carrola1/CommandCenter/Lessons Learned.txt

- To get audio files playing I had to turn compile optimization ON (optimize for size).
  * Not sure why this is, but it may have something to do with an undefined array size
    in the fatfs code that is allocating more RAM than is allowable. Just a guess.
