carrola1/CommandCenter/Hardware/CommandCenter_BOM.xlsx

Id | Designator | Manufacturer | Part # | Description | Value | Package | Quantity | Cost/pc | Cost Total
1 | R33,R1,R2,R5,R7,R8,R9,R10,R11,R12,R14,R19,R23,R24,R26,R28,R30,R31,R32,R35,R37,R38,R39,R41,R42,R43,R44,R45,R46,R47,R34,R36 | Stackpole Electronics | RNCP0603FTD10K0 | 10k Resistor | 10k | 0603 | 32 | $0.03 | $0.87
2 | BAR4,BAR3 | Broadcom Limited | HDSP-4850 | Bar Graph (Green) | N/A | N/A | 2 | $5.83 | $11.66
3 | BAR1,BAR2 | Broadcom Limited | HDSP-4830 | Bar Graph (Red) | N/A | N/A | 2 | $6.06 | $12.12
4 | C6 |  |  |  | 0.1u | 0402 | 1 |  | $0.00
5 | C7,C12,C16,C17 | Samsung | CL10A106MQ8NNNC | 10uF Capacitor | 10u | 0603 | 4 | $0.11 | $0.44
6 | C8 | Samsung | CL10A105KP8NNNC | 1uF Capacitor | 1u | 0603 | 1 | $0.02 | $0.02
7 | C9,C11 | Samsung | CL10A225KO8NNNC | 2.2uF Capacitor | 2.2u | 0603 | 2 | $0.13 | $0.26
8 | C10 |  |  |  | 220u | 1206 | 1 |  | $0.00
9 | D1,D2 | Lite-On | LTST-C191KGKT | Green LED | LED | 0603 | 2 | $0.29 | $0.58
10 | J2 |  |  |  | Motor_Switches | PinHeader_1x04_P2.54mm_Vertical | 1 |  | $0.00
11 | J3,J17 | Amphenol | 20021121-00010C4LF | SWD Header | N/A | N/A | 2 | $0.84 | $1.68
12 | J4 |  |  |  | Motor | PinHeader_1x03_P2.54mm_Vertical | 1 |  | $0.00
13 | J5 | Molex | 5031821852 | Micro SD card holder | N/A | N/A | 1 | $2.45 | $2.45
14 | J6 |  |  |  | SPKR0 | PinHeader_1x02_P2.54mm_Vertical | 1 |  | $0.00
15 | J7 |  |  |  | SPKR1 | PinHeader_1x02_P2.54mm_Vertical | 1 |  | $0.00
16 | J8 |  |  |  | LED0 | PinHeader_1x02_P2.54mm_Vertical | 1 |  | $0.00
17 | J9 |  |  |  | LED1 | PinHeader_1x02_P2.54mm_Vertical | 1 |  | $0.00
18 | J10 |  |  |  | LED2 | PinHeader_1x02_P2.54mm_Vertical | 1 |  | $0.00
19 | J11 |  |  |  | LED3 | PinHeader_1x02_P2.54mm_Vertical | 1 |  | $0.00
20 | J12 |  |  |  | Wake | PinHeader_1x02_P2.54mm_Vertical | 1 |  | $0.00
21 | J15 |  |  |  | SW2 | PinHeader_1x02_P2.54mm_Vertical | 1 |  | $0.00
22 | J16 |  |  |  | SW3 | PinHeader_1x02_P2.54mm_Vertical | 1 |  | $0.00
23 | J18 |  |  |  | Bar Graph SW | PinHeader_1x09_P2.54mm_Vertical | 1 |  | $0.00
24 | L1 | Sumida | CDRH124NP-6R8MC | Inductor | 6.8uH | L_12x12mm_H4.5mm | 1 | $1.41 | $1.41
25 | Q1,Q2,Q3,Q4,Q5,Q6 | Diodes Inc | DMG1012T-7 | Dual N-Channel MOSFET | N/A | SOT-523 | 6 | $0.31 | $1.86
26 | R3,R20,R21,R25,R27,R29 | Stackpole Electronics | RMCF0603FT121R | 121 Resistor | 121 | 0603 | 6 | $0.01 | $0.04
27 | R4,R15,R17,R22 |  |  |  | DNP | 0603 | 4 |  | $0.00
28 | R6 | Stackpole Electronics | RMCF0603FT30K1 | 30k Resistor | 30k | 0603 | 1 | $0.02 | $0.02
29 | R13,R16,R18,R40 | Stackpole Electronics | RMCF0603FT100K | 100k Resistor | 100k | 0603 | 4 | $0.01 | $0.03
30 | R48 | TE Connectivity | CRGCQ0603F15K | 15k Resistor | 15k | 0603 | 1 | $0.03 | $0.03
31 | R49 | TE Connectivity | CRGCQ0603J22K | 22k Resistor | 22k | 0603 | 1 | $0.02 | $0.02
32 | U1 | Texas Instruments | TPS61032PWPR | 5V Boost Converter | TPS61032 | 16HTSSOP | 1 | $2.76 | $2.76
33 | U2,U6 | STMicroelectronics | STM32L052C8T6 | Microcontroller | N/A | 48LQFP | 2 | $3.77 | $7.54
34 | U3 | Microchip | MIC5225-3.3YM5-TR | 3.3V LDO | MIC5225 | SOT-23-5 | 1 | $0.40 | $0.40
35 | U4,U5 | Maxim | MAX98357AETE+T | I2S Class D Audio Amp | MAX98357 | 16TQFN | 2 | $2.40 | $4.80
36 | U7 | Broadcom Limited | APDS-9960 | Color sensor | APDS-9960 | Ambient_Prox_APDS-9960 | 1 | $2.72 | $2.72
37 | U8,U9,U10,U11,U12,U14,U15,U16,U17,U18,U19,U20,U21,U22,U23,U24,U25,U26,U27,U28 | SparkFun Electronics | COM-14863 | 10-pack APA102 RGB LED | N/A | N/A | 2 | $3.95 | $7.90
38 | U13 | Texas Instruments | SN74LVC2T45DCUR | Level translator | SN74LVC2T45 | US8 | 1 | $0.71 | $0.71
39 | U29 | Maxim | MAX7219CWG+T | Display driver | N/A | 24SOIC | 1 | $10.43 | $10.43
40 | U30 | Texas Instruments |  | Level translator | TXS0104EPWR | 14TSSOP | 1 |  | $0.00
41 | C1,C2,C3,C5,C13,C14,C15,C19,C20,C21,C22,C23,C24,C25,C26,C27,C28,C29,C30,C31,C32,C33,C34,C35,C36,C37,C38,C39,C40,C41,C42,C43,C44,C45,C46,C47,C48 | Samsung | CL10B104KB8NNNC | 0.1uF capacitor | 0.1u | 0603 | 37 | $0.01 | $0.46
42 | J1 | JST | S2B-PH-K-S(LF)(SN) | Battery connector | N/A | N/A | 1 | $0.17 | $0.17
43 | J13 |  |  |  | SW0 | PinHeader_1x02_P2.54mm_Vertical | 1 |  | $0.00
44 | J14 |  |  |  | SW1 | PinHeader_1x02_P2.54mm_Vertical | 1 |  | $0.00
 |  |  |  |  |  |  |  |  | $71.37
