carrola1/CommandCenter/Hardware/Part List.xlsx

Sheet: Sheet1
Part # | Description | Package | Vendor | Qty | Unit Cost | Total | In Stock
STM32L052C8T6 | Cortex-M0+, 64kB flash, 64kB RAM, 3xSPI/I2S. 1 DAC. | 48-LQFP | STMicro | 2 | $3.77 | $7.54
MAX98357A | I2S Class D audio amp | 16-TQFN | Maxim | 2 | $2.22 | $4.44
5031821852 | Micro SD connector | SMD | Molex | 1 | $2.33
TPS61032 | 5V boost converter | 16-TSSOP | TI | 1 | $2.76
MIC5225-3.3 | Linear regulator | SOT-23-5 | Microchip | 1 | $0.41
COM-14863 | DotStar | PLCC-6 | SparkFun | 2 | $3.95 |  | 4
LTST-C191KGKT | Green LED, 2V, 20mA | 0603 | Lite-On | 2 | $0.29
LTST-C191KFKT | Orange LED, 2V, 20mA | 0603 | Lite-On | 2 | $0.29
CDRH124NP-6R8MC | Inductor, 6.8uH | 12x12mm | Sumida | 1 | $1.41
SN74LVC2T45 | Dual Level Translator | 8-VSSOP | TI | 1 | $0.61
20021121-00010C4LF | 10-pin header - .005" | SMT | Amphenol | 2 | $0.84
APDS-9960 | Color/proximity sensor | SMD (8) | Broadcom | 1 | $2.72
1314 | Speaker - 3" Diameter - 4 Ohm 3 Watt | N/A | Adafruit | 2 | $1.95 |  | 2
HDSP-4830 | Red Bar Graph | DIP (8) | Broadcom | 2 | $6.06
HDSP-4850 | Green Bar Graph | DIP (8) | Broadcom | 2 | $5.83
1675 | SWD Programming cable |  | Adafruit | 1 | $2.95
DMG1012T-7 | N-Channel FET | SOT-523 | Diodes | 6 | $0.34
MAX7219 | LED driver | SOIC | Maxim | 1 | $10.43
TXB0104PW | Quad level translator | TSSOP | TI
2925 | Mini 8-way rotary selector switch |  | Adafruit | 1 | $1.95
1445 | 16mm Panel Mount Momentary Pushbutton - Red |  | Adafruit | 1 | $0.95 | $0.95 | 1
2046 | Potentiometer Knob - Soft Touch T18 - Red |  | Adafruit | 1 | $0.50 | $0.50
56DP30-01-1-AJN | Rotary switch - SP12T with adjustable stops |  | Digikey | 1 | $9.95 | $9.95 | 1
169 | Micro servo |  | Adafruit | 1 | $5.95 | $5.95 | 1
KO106A102 | Key lock switch (panel mount) |  | Digikey | 1 | $3.46 | $3.46 | 1
6081231110F | Green panel mount LED w/wires |  | Digikey | 1 | $3.25 | $3.25
6081131110F | Red panel mount LED w/wires |  | Digikey | 1 | $3.35 | $3.35
6083331110F | Yellow panel mount LED w/wires |  | Digikey | 1 | $3.25 | $3.25
‎S2B-PH-K-S | Power connector, right angle |  |  | 1 | $0.17 | $0.17
ST161D00 | SPST switch |  |  | 3
 | 3xAA battery holder
 | 0.1u | 0603 |  | 37
 | 10k | 0603 |  | 32
 | 0.1u | 0402 |  | 1
 | 10u | 0603 |  | 4
 | 1u | 0603 |  | 1
 | 2.2u | 0603 |  | 2
 | 220u | 1206 |  | 1
 | 121 | 0603 |  | 6
 | 30k | 0603 |  | 1
 | 100k | 0603 |  | 4
 | 15k | 0603 |  | 1
 | 22k | 0603 |  | 1
 | Test Point 2x2 mm |  |  | 9
 |  |  |  |  | TOTAL | $30.83

Sheet: Sheet3
Id | Designator | Package | Quantity | Designation | Supplier and ref | Column1 | _1
1 | R33,R1,R2,R5,R7,R8,R9,R10,R11,R12,R14,R19,R23,R24,R26,R28,R30,R31,R32,R35,R37,R38,R39,R41,R42,R43,R44,R45,R46,R47,R34,R36 | R_0603_1608Metric_Pad1.05x0.95mm_HandSolder | 32 | 10k
2 | BAR4,BAR1,BAR2,BAR3 | HDSP-4830 | 4 | HDSP-4830_2
3 | C6 | C_0402_1005Metric | 1 | 0.1u
4 | C7,C12,C16,C17 | C_0603_1608Metric_Pad1.05x0.95mm_HandSolder | 4 | 10u
5 | C8 | C_0603_1608Metric_Pad1.05x0.95mm_HandSolder | 1 | 1u
6 | C9,C11 | C_0603_1608Metric_Pad1.05x0.95mm_HandSolder | 2 | 2.2u
7 | C10 | C_1206_3216Metric_Pad1.42x1.75mm_HandSolder | 1 | 220u
8 | D1,D2 | LED_0603_1608Metric_Pad1.05x0.95mm_HandSolder | 2 | LED
9 | J2 | PinHeader_1x04_P2.54mm_Vertical | 1 | Motor_Switches
10 | J3,J17 | JLink_Mini_0p05 | 2 | JLink_Mini
11 | J4 | PinHeader_1x03_P2.54mm_Vertical | 1 | Motor
12 | J5 | MOLEX_503182-1852 | 1 | 503182-1852
13 | J6 | PinHeader_1x02_P2.54mm_Vertical | 1 | SPKR0
14 | J7 | PinHeader_1x02_P2.54mm_Vertical | 1 | SPKR1
15 | J8 | PinHeader_1x02_P2.54mm_Vertical | 1 | LED0
16 | J9 | PinHeader_1x02_P2.54mm_Vertical | 1 | LED1
17 | J10 | PinHeader_1x02_P2.54mm_Vertical | 1 | LED2
18 | J11 | PinHeader_1x02_P2.54mm_Vertical | 1 | LED3
19 | J12 | PinHeader_1x02_P2.54mm_Vertical | 1 | Wake
20 | J15 | PinHeader_1x02_P2.54mm_Vertical | 1 | SW2
21 | J16 | PinHeader_1x02_P2.54mm_Vertical | 1 | SW3
22 | J18 | PinHeader_1x09_P2.54mm_Vertical | 1 | Bar Graph SW
23 | L1 | L_12x12mm_H4.5mm | 1 | 6.8u
24 | Q1,Q2,Q3,Q4,Q5,Q6 | SOT-523 | 6 | DMG1012T-7
25 | R3,R20,R21,R25,R27,R29 | R_0603_1608Metric_Pad1.05x0.95mm_HandSolder | 6 | 121
26 | R4,R15,R17,R22 | R_0603_1608Metric_Pad1.05x0.95mm_HandSolder | 4 | DNP
27 | R6 | R_0603_1608Metric_Pad1.05x0.95mm_HandSolder | 1 | 30k
28 | R13,R16,R18,R40 | R_0603_1608Metric_Pad1.05x0.95mm_HandSolder | 4 | 100k
29 | R48 | R_0603_1608Metric_Pad1.05x0.95mm_HandSolder | 1 | 15k
30 | R49 | R_0603_1608Metric_Pad1.05x0.95mm_HandSolder | 1 | 22k
31 | TP1 | TestPoint_Pad_2.0x2.0mm | 1 | MOSI
32 | TP2 | TestPoint_Pad_2.0x2.0mm | 1 | MISO
33 | TP3 | TestPoint_Pad_2.0x2.0mm | 1 | SCK
34 | TP4 | TestPoint_Pad_2.0x2.0mm | 1 | NSS
35 | TP5 | TestPoint_Pad_2.0x2.0mm | 1 | I2S_WS
36 | TP6 | TestPoint_Pad_2.0x2.0mm | 1 | I2S_CK
37 | TP7 | TestPoint_Pad_2.0x2.0mm | 1 | I2S_SD
38 | TP8 | TestPoint_Pad_2.0x2.0mm | 1 | DOTSTAR_DATA
39 | TP9 | TestPoint_Pad_2.0x2.0mm | 1 | DOTSTAR_CLK
40 | U1 | SOP65P640X120-17N | 1 | TPS61032
41 | U2,U6 | QFP50P900X900X160-48N | 2 | STM32L0-LQFP48
42 | U3 | SOT-23-5 | 1 | MIC5225
43 | U4,U5 | QFN50P300X300X80-17N | 2 | MAX98357
44 | U7 | Ambient_Prox_APDS-9960 | 1 | APDS-9960
45 | U8,U9,U10,U11,U12,U14,U15,U16,U17,U18,U19,U20,U21,U22,U23,U24,U25,U26,U27,U28 | APA102_hand_solder | 20 | APA102
46 | U13 | SOP50P310X90-8N | 1 | SN74LVC2T45
47 | U29 | SOIC-24W_7.5x15.4mm_P1.27mm | 1 | MAX7219
48 | U30 | TSSOP-14_4.4x5mm_P0.65mm | 1 | TXB0104PW
49 | C1,C2,C3,C5,C13,C14,C15,C19,C20,C21,C22,C23,C24,C25,C26,C27,C28,C29,C30,C31,C32,C33,C34,C35,C36,C37,C38,C39,C40,C41,C42,C43,C44,C45,C46,C47,C48 | C_0603_1608Metric_Pad1.05x0.95mm_HandSolder | 37 | 0.1u
50 | MK1,MK2,MK3,MKe | MountingHole_3.2mm_M3 | 4 | Mounting_Hole
51 | J1 | JST_PH_S2B-PH-K_1x02_P2.00mm_Horizontal | 1 | Battery
52 | J13 | PinHeader_1x02_P2.54mm_Vertical | 1 | SW0
53 | J14 | PinHeader_1x02_P2.54mm_Vertical | 1 | SW1
