carrola1/CommandCenter/Hardware/CommandCenter_KICAD/CommandCenter_KICAD.kicad_pcb

## KiCad design Hardware/CommandCenter_KICAD/CommandCenter_KICAD.kicad_pcb (2019-08-28)

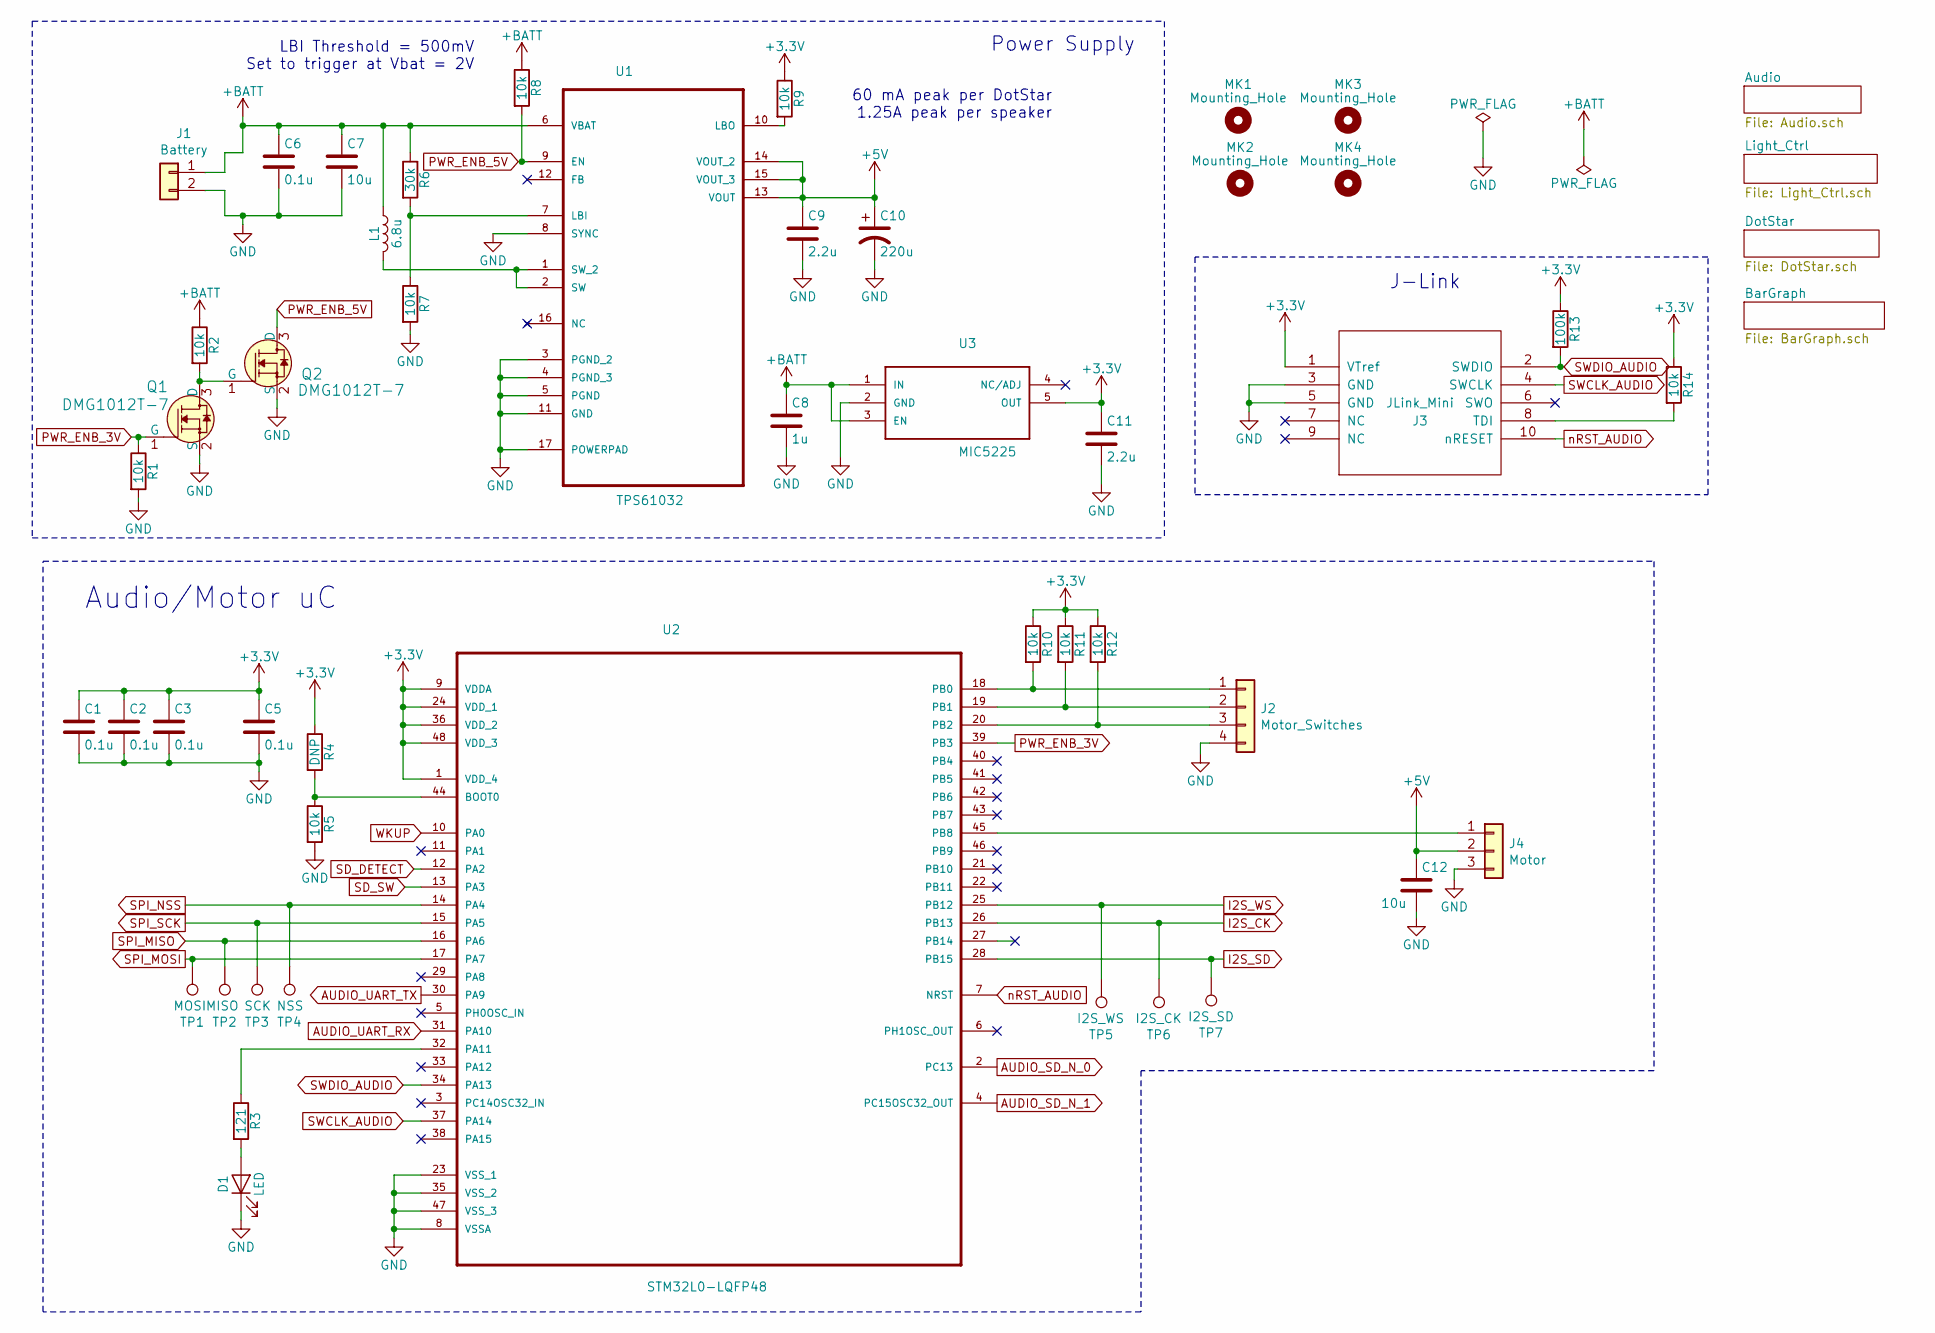
[picture p1: schematic CommandCenter_KICAD.sch]

Parts:
C1, C2, C3, C5: 0.1u; C_0603_1608Metric_Pad1.05x0.95mm_HandSolder
C6: 0.1u; C_0402_1005Metric
C7, C12: 10u; C_0603_1608Metric_Pad1.05x0.95mm_HandSolder
C8: 1u; C_0603_1608Metric_Pad1.05x0.95mm_HandSolder
C9, C11: 2.2u; C_0603_1608Metric_Pad1.05x0.95mm_HandSolder
C10: 220u; C_1206_3216Metric_Pad1.42x1.75mm_HandSolder
D1: LED; LED_0603_1608Metric_Pad1.05x0.95mm_HandSolder
J1: Battery; JST_PH_S2B-PH-K_1x02_P2.00mm_Horizontal
J2: Motor_Switches; PinHeader_1x04_P2.54mm_Vertical
J3: JLink_Mini; JLink_Mini_0p05
J4: Motor; PinHeader_1x03_P2.54mm_Vertical
L1: 6.8u; L_12x12mm_H4.5mm
MK1, MK2, MK3, MK4: Mounting_Hole; MountingHole_3.2mm_M3
Q1, Q2: DMG1012T-7; SOT-523; MPN DMG1012T-7; Digi-Key_PN DMG1012T-7DICT-ND
R1, R2, R5, R7, R8, R9, R10, R11, R12, R14: 10k; R_0603_1608Metric_Pad1.05x0.95mm_HandSolder
R3: 121; R_0603_1608Metric_Pad1.05x0.95mm_HandSolder
R4: DNP; R_0603_1608Metric_Pad1.05x0.95mm_HandSolder
R6: 30k; R_0603_1608Metric_Pad1.05x0.95mm_HandSolder
R13: 100k; R_0603_1608Metric_Pad1.05x0.95mm_HandSolder
TP1: MOSI; TestPoint_Pad_2.0x2.0mm
TP2: MISO; TestPoint_Pad_2.0x2.0mm
TP3: SCK; TestPoint_Pad_2.0x2.0mm
TP4: NSS; TestPoint_Pad_2.0x2.0mm
TP5: I2S_WS; TestPoint_Pad_2.0x2.0mm
TP6: I2S_CK; TestPoint_Pad_2.0x2.0mm
TP7: I2S_SD; TestPoint_Pad_2.0x2.0mm
U1: TPS61032; SOP65P640X120-17N
U2: STM32L0-LQFP48; QFP50P900X900X160-48N
U3: MIC5225; SOT-23-5

Connections:
+3V3: C1.1, C2.1, C3.1, C5.1, C11.1, J3.1 (VTref), R4.1, R9.1, R10.1, R11.1, R12.1, R13.1, R14.1, U2.1 (VDD_4), U2.9 (VDDA), U2.24 (VDD_1), U2.36 (VDD_2), U2.48 (VDD_3), U3.5 (OUT); also elsewhere on the board
+5V: C9.1, C10.1, C12.1, J4.2, U1.13 (VOUT), U1.14 (VOUT_2), U1.15 (VOUT_3); also elsewhere on the board
+BATT: C6.1, C7.1, C8.1, J1.1, L1.1, R2.1, R6.1, R8.1, U1.6 (VBAT), U3.1 (IN), U3.3 (EN)
AUDIO_SD_N_0: U2.2 (PC13); also elsewhere on the board
AUDIO_SD_N_1: U2.4 (PC15OSC32_OUT); also elsewhere on the board
AUDIO_UART_RX: U2.31 (PA10); also elsewhere on the board
AUDIO_UART_TX: U2.30 (PA9); also elsewhere on the board
GND: C1.2, C2.2, C3.2, C5.2, C6.2, C7.2, C8.2, C9.2, C10.2, C11.2, C12.2, D1.1 (K), J1.2, J2.4, J3.3 (GND), J3.5 (GND), J4.3, Q1.2 (S), Q2.2 (S), R1.2, R5.2, R7.2, U1.3 (PGND_2), U1.4 (PGND_3), U1.5 (PGND), U1.8 (SYNC), U1.11 (GND), U1.17 (POWERPAD), U2.8 (VSSA), U2.23 (VSS_1), U2.35 (VSS_2), U2.47 (VSS_3), U3.2 (GND); also elsewhere on the board
I2S_CK: TP6.1, U2.26 (PB13); also elsewhere on the board
I2S_SD: TP7.1, U2.28 (PB15); also elsewhere on the board
I2S_WS: TP5.1, U2.25 (PB12); also elsewhere on the board
unnamed: D1.2 (A), R3.2
unnamed: J2.1, R10.2, U2.18 (PB0)
unnamed: J2.2, R11.2, U2.19 (PB1)
unnamed: J2.3, R12.2, U2.20 (PB2)
unnamed: J3.8 (TDI), R14.2
unnamed: J4.1, U2.45 (PB8)
unnamed: L1.2, U1.1 (SW_2), U1.2 (SW)
unnamed: Q1.3 (D), Q2.1 (G), R2.2
unnamed: R3.1, U2.32 (PA11)
unnamed: R4.2, R5.1, U2.44 (BOOT0)
unnamed: R6.2, R7.1, U1.7 (LBI)
unnamed: R9.2, U1.10 (LBO)
PWR_ENB_3V: Q1.1 (G), R1.1, U2.39 (PB3)
PWR_ENB_5V: Q2.3 (D), R8.2, U1.9 (EN)
SD_DETECT: U2.12 (PA2); also elsewhere on the board
SD_SW: U2.13 (PA3); also elsewhere on the board
SPI_MISO: TP2.1, U2.16 (PA6); also elsewhere on the board
SPI_MOSI: TP1.1, U2.17 (PA7); also elsewhere on the board
SPI_NSS: TP4.1, U2.14 (PA4); also elsewhere on the board
SPI_SCK: TP3.1, U2.15 (PA5); also elsewhere on the board
SWCLK_AUDIO: J3.4 (SWCLK), U2.37 (PA14)
SWDIO_AUDIO: J3.2 (SWDIO), R13.2, U2.34 (PA13)
WKUP: U2.10 (PA0); also elsewhere on the board
nRST_AUDIO: J3.10 (nRESET), U2.7 (NRST)

Notes on the sheet:
Power Supply
J-Link
Audio/Motor uC
60 mA peak per DotStar 1.25A peak per speaker
LBI Threshold = 500mV Set to trigger at Vbat = 2V

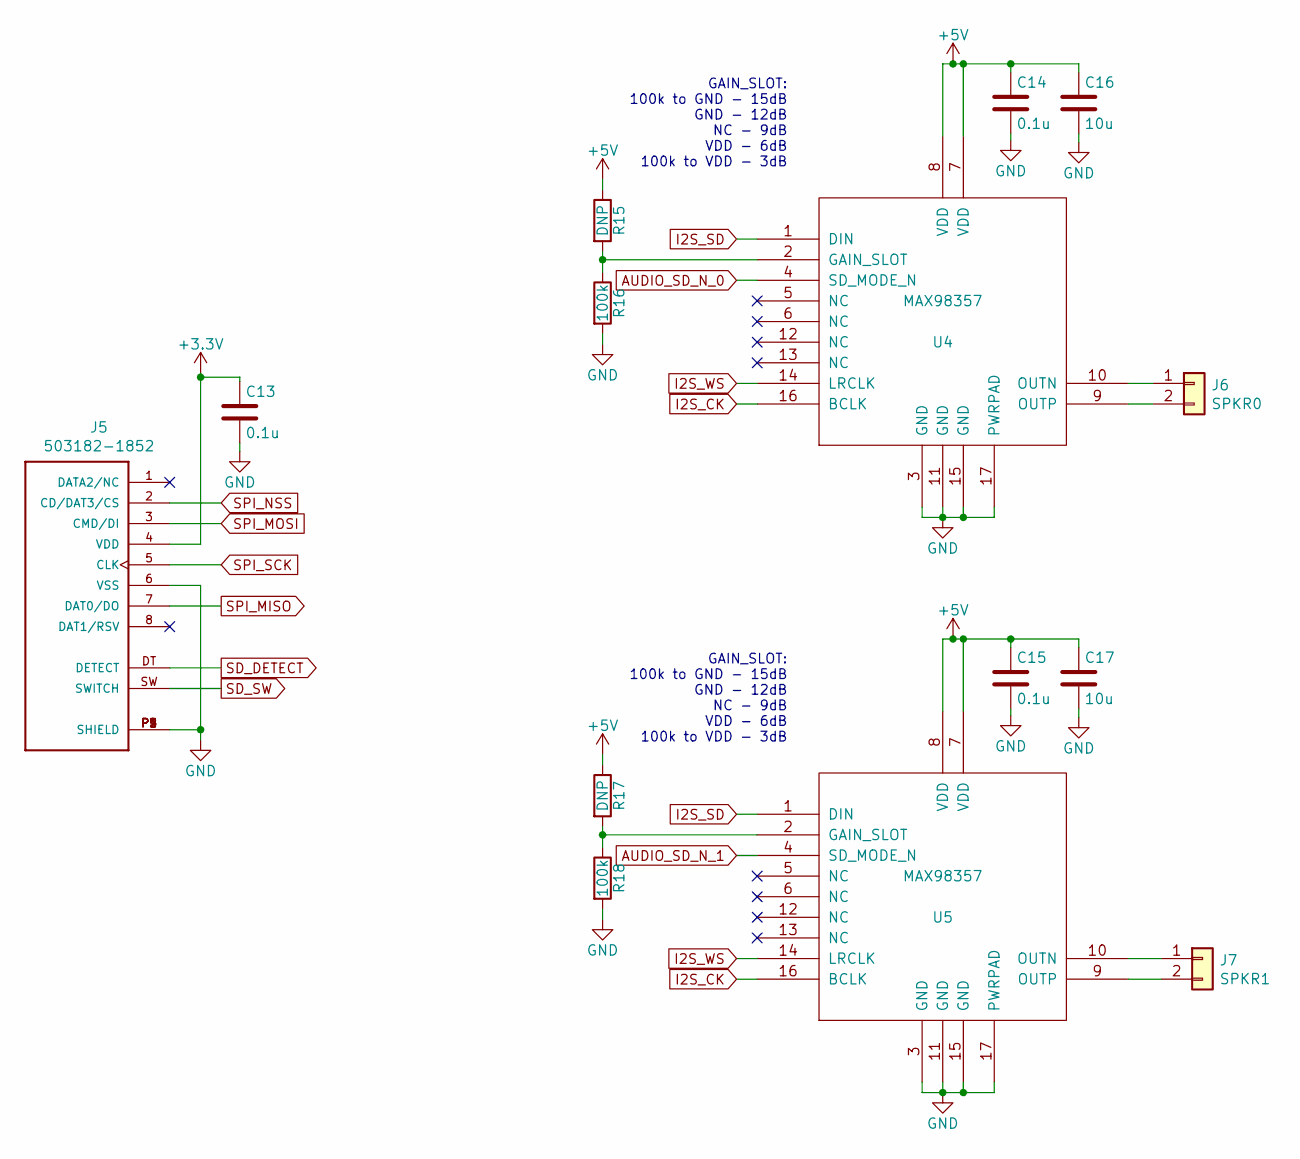
[picture p2: schematic Audio.sch]

Parts:
C13, C14, C15: 0.1u; C_0603_1608Metric_Pad1.05x0.95mm_HandSolder
C16, C17: 10u; C_0603_1608Metric_Pad1.05x0.95mm_HandSolder
J5: 503182-1852; MOLEX_503182-1852
J6: SPKR0; PinHeader_1x02_P2.54mm_Vertical
J7: SPKR1; PinHeader_1x02_P2.54mm_Vertical
R15, R17: DNP; R_0603_1608Metric_Pad1.05x0.95mm_HandSolder
R16, R18: 100k; R_0603_1608Metric_Pad1.05x0.95mm_HandSolder
U4, U5: MAX98357; QFN50P300X300X80-17N

Connections:
+3V3: C13.1, J5.4 (VDD); also elsewhere on the board
+5V: C14.1, C15.1, C16.1, C17.1, R15.1, R17.1, U4.7 (VDD), U4.8 (VDD), U5.7 (VDD), U5.8 (VDD); also elsewhere on the board
AUDIO_SD_N_0: U4.4 (SD_MODE_N); also elsewhere on the board
AUDIO_SD_N_1: U5.4 (SD_MODE_N); also elsewhere on the board
GND: C13.2, C14.2, C15.2, C16.2, C17.2, J5.6 (VSS), J5.P1 (SHIELD), J5.P2 (SHIELD), J5.P3 (SHIELD), J5.P4 (SHIELD), J5.P5 (SHIELD), R16.2, R18.2, U4.3 (GND), U4.11 (GND), U4.15 (GND), U4.17 (PWRPAD), U5.3 (GND), U5.11 (GND), U5.15 (GND), U5.17 (PWRPAD); also elsewhere on the board
I2S_CK: U4.16 (BCLK), U5.16 (BCLK); also elsewhere on the board
I2S_SD: U4.1 (DIN), U5.1 (DIN); also elsewhere on the board
I2S_WS: U4.14 (LRCLK), U5.14 (LRCLK); also elsewhere on the board
unnamed: J6.1, U4.10 (OUTN)
unnamed: J6.2, U4.9 (OUTP)
unnamed: J7.1, U5.10 (OUTN)
unnamed: J7.2, U5.9 (OUTP)
unnamed: R15.2, R16.1, U4.2 (GAIN_SLOT)
unnamed: R17.2, R18.1, U5.2 (GAIN_SLOT)
SD_DETECT: J5.DT (DETECT); also elsewhere on the board
SD_SW: J5.SW (SWITCH); also elsewhere on the board
SPI_MISO: J5.7 (DAT0/DO); also elsewhere on the board
SPI_MOSI: J5.3 (CMD/DI); also elsewhere on the board
SPI_NSS: J5.2 (CD/DAT3/CS); also elsewhere on the board
SPI_SCK: J5.5 (CLK); also elsewhere on the board

Notes on the sheet:
GAIN_SLOT: 100k to GND - 15dB GND - 12dB NC - 9dB VDD - 6dB 100k to VDD - 3dB

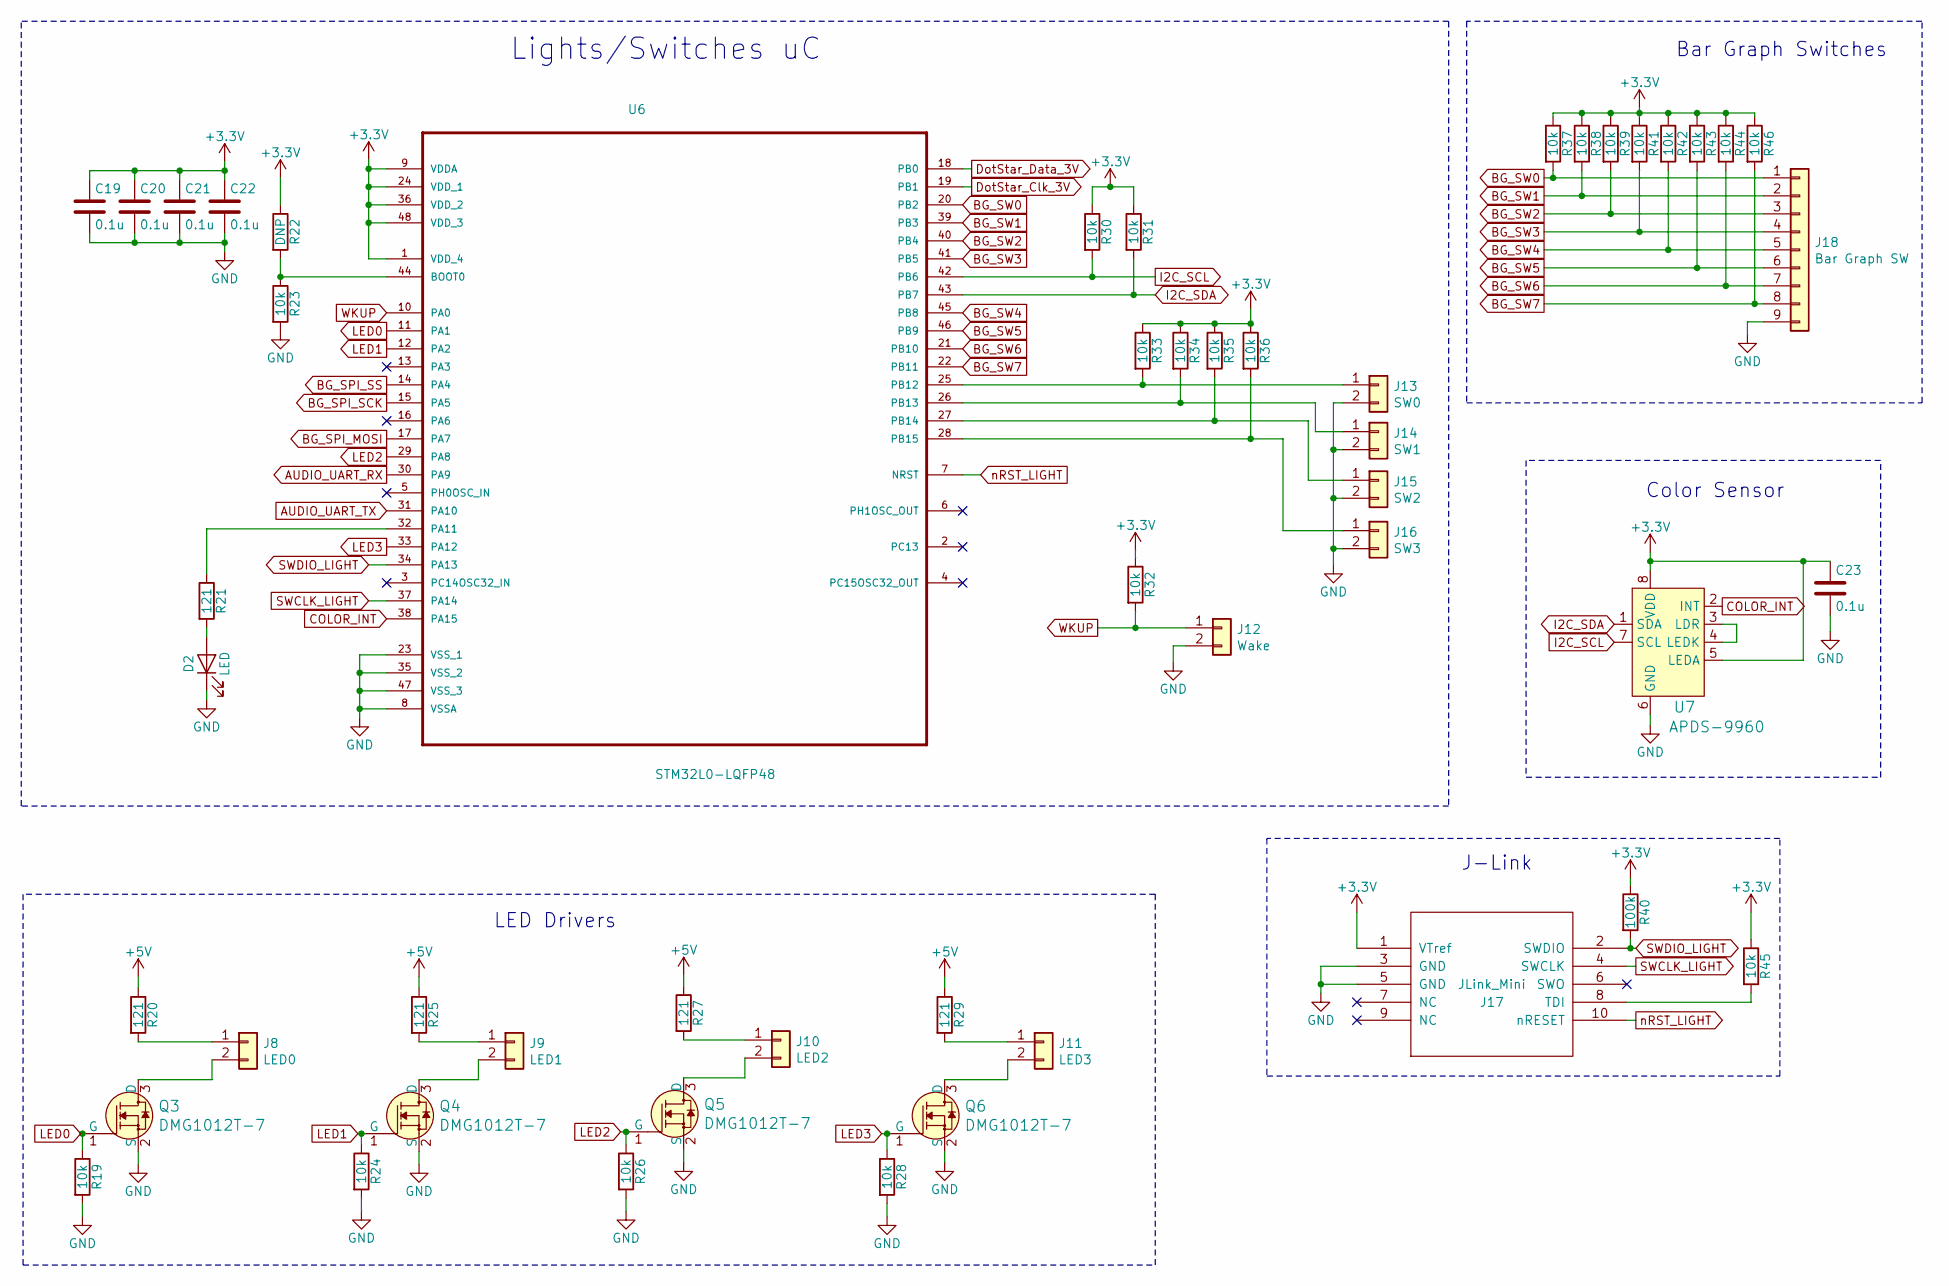
[picture p3: schematic Light_Ctrl.sch]

Parts:
C19, C20, C21, C22, C23: 0.1u; C_0603_1608Metric_Pad1.05x0.95mm_HandSolder
D2: LED; LED_0603_1608Metric_Pad1.05x0.95mm_HandSolder
J8: LED0; PinHeader_1x02_P2.54mm_Vertical
J9: LED1; PinHeader_1x02_P2.54mm_Vertical
J10: LED2; PinHeader_1x02_P2.54mm_Vertical
J11: LED3; PinHeader_1x02_P2.54mm_Vertical
J12: Wake; PinHeader_1x02_P2.54mm_Vertical
J13: SW0; PinHeader_1x02_P2.54mm_Vertical
J14: SW1; PinHeader_1x02_P2.54mm_Vertical
J15: SW2; PinHeader_1x02_P2.54mm_Vertical
J16: SW3; PinHeader_1x02_P2.54mm_Vertical
J17: JLink_Mini; JLink_Mini_0p05
J18: Bar Graph SW; PinHeader_1x09_P2.54mm_Vertical
Q3, Q4, Q5, Q6: DMG1012T-7; SOT-523; MPN DMG1012T-7; Digi-Key_PN DMG1012T-7DICT-ND
R19, R23, R24, R26, R28, R30, R31, R32, R33, R34, R35, R36, R37, R38, R39, R41, R42, R43, R44, R45, R46: 10k; R_0603_1608Metric_Pad1.05x0.95mm_HandSolder
R20, R21, R25, R27, R29: 121; R_0603_1608Metric_Pad1.05x0.95mm_HandSolder
R22: DNP; R_0603_1608Metric_Pad1.05x0.95mm_HandSolder
R40: 100k; R_0603_1608Metric_Pad1.05x0.95mm_HandSolder
U6: STM32L0-LQFP48; QFP50P900X900X160-48N
U7: APDS-9960; Ambient_Prox_APDS-9960; MPN APDS-9960; Digi-Key_PN 516-3480-1-ND

Connections:
+3V3: C19.1, C20.1, C21.1, C22.1, C23.1, J17.1 (VTref), R22.1, R30.1, R31.1, R32.1, R33.1, R34.1, R35.1, R36.1, R37.1, R38.1, R39.1, R40.1, R41.1, R42.1, R43.1, R44.1, R45.1, R46.1, U6.1 (VDD_4), U6.9 (VDDA), U6.24 (VDD_1), U6.36 (VDD_2), U6.48 (VDD_3), U7.5 (LEDA), U7.8 (VDD); also elsewhere on the board
+5V: R20.1, R25.1, R27.1, R29.1; also elsewhere on the board
AUDIO_UART_RX: U6.30 (PA9); also elsewhere on the board
AUDIO_UART_TX: U6.31 (PA10); also elsewhere on the board
BG_SPI_MOSI: U6.17 (PA7); also elsewhere on the board
BG_SPI_SCK: U6.15 (PA5); also elsewhere on the board
BG_SPI_SS: U6.14 (PA4); also elsewhere on the board
BG_SW0: J18.1, R37.2, U6.20 (PB2)
BG_SW1: J18.2, R38.2, U6.39 (PB3)
BG_SW2: J18.3, R39.2, U6.40 (PB4)
BG_SW3: J18.4, R41.2, U6.41 (PB5)
BG_SW4: J18.5, R42.2, U6.45 (PB8)
BG_SW5: J18.6, R43.2, U6.46 (PB9)
BG_SW6: J18.7, R44.2, U6.21 (PB10)
BG_SW7: J18.8, R46.2, U6.22 (PB11)
COLOR_INT: U6.38 (PA15), U7.2 (INT)
DotStar_Clk_3V: U6.19 (PB1); also elsewhere on the board
DotStar_Data_3V: U6.18 (PB0); also elsewhere on the board
GND: C19.2, C20.2, C21.2, C22.2, C23.2, D2.1 (K), J12.2, J13.2, J14.2, J15.2, J16.2, J17.3 (GND), J17.5 (GND), J18.9, Q3.2 (S), Q4.2 (S), Q5.2 (S), Q6.2 (S), R19.2, R23.2, R24.2, R26.2, R28.2, U6.8 (VSSA), U6.23 (VSS_1), U6.35 (VSS_2), U6.47 (VSS_3), U7.6 (GND); also elsewhere on the board
I2C_SCL: R30.2, U6.42 (PB6), U7.7 (SCL)
I2C_SDA: R31.2, U6.43 (PB7), U7.1 (SDA)
LED0: Q3.1 (G), R19.1, U6.11 (PA1)
LED1: Q4.1 (G), R24.1, U6.12 (PA2)
LED2: Q5.1 (G), R26.1, U6.29 (PA8)
LED3: Q6.1 (G), R28.1, U6.33 (PA12)
unnamed: D2.2 (A), R21.2
unnamed: J8.1, R20.2
unnamed: J8.2, Q3.3 (D)
unnamed: J9.1, R25.2
unnamed: J9.2, Q4.3 (D)
unnamed: J10.1, R27.2
unnamed: J10.2, Q5.3 (D)
unnamed: J11.1, R29.2
unnamed: J11.2, Q6.3 (D)
unnamed: J13.1, R33.2, U6.25 (PB12)
unnamed: J14.1, R34.2, U6.26 (PB13)
unnamed: J15.1, R35.2, U6.27 (PB14)
unnamed: J16.1, R36.2, U6.28 (PB15)
unnamed: J17.8 (TDI), R45.2
unnamed: R21.1, U6.32 (PA11)
unnamed: R22.2, R23.1, U6.44 (BOOT0)
unnamed: U7.3 (LDR), U7.4 (LEDK)
SWCLK_LIGHT: J17.4 (SWCLK), U6.37 (PA14)
SWDIO_LIGHT: J17.2 (SWDIO), R40.2, U6.34 (PA13)
WKUP: J12.1, R32.2, U6.10 (PA0); also elsewhere on the board
nRST_LIGHT: J17.10 (nRESET), U6.7 (NRST)

Notes on the sheet:
Lights/Switches uC
J-Link
LED Drivers
Color Sensor
Bar Graph Switches

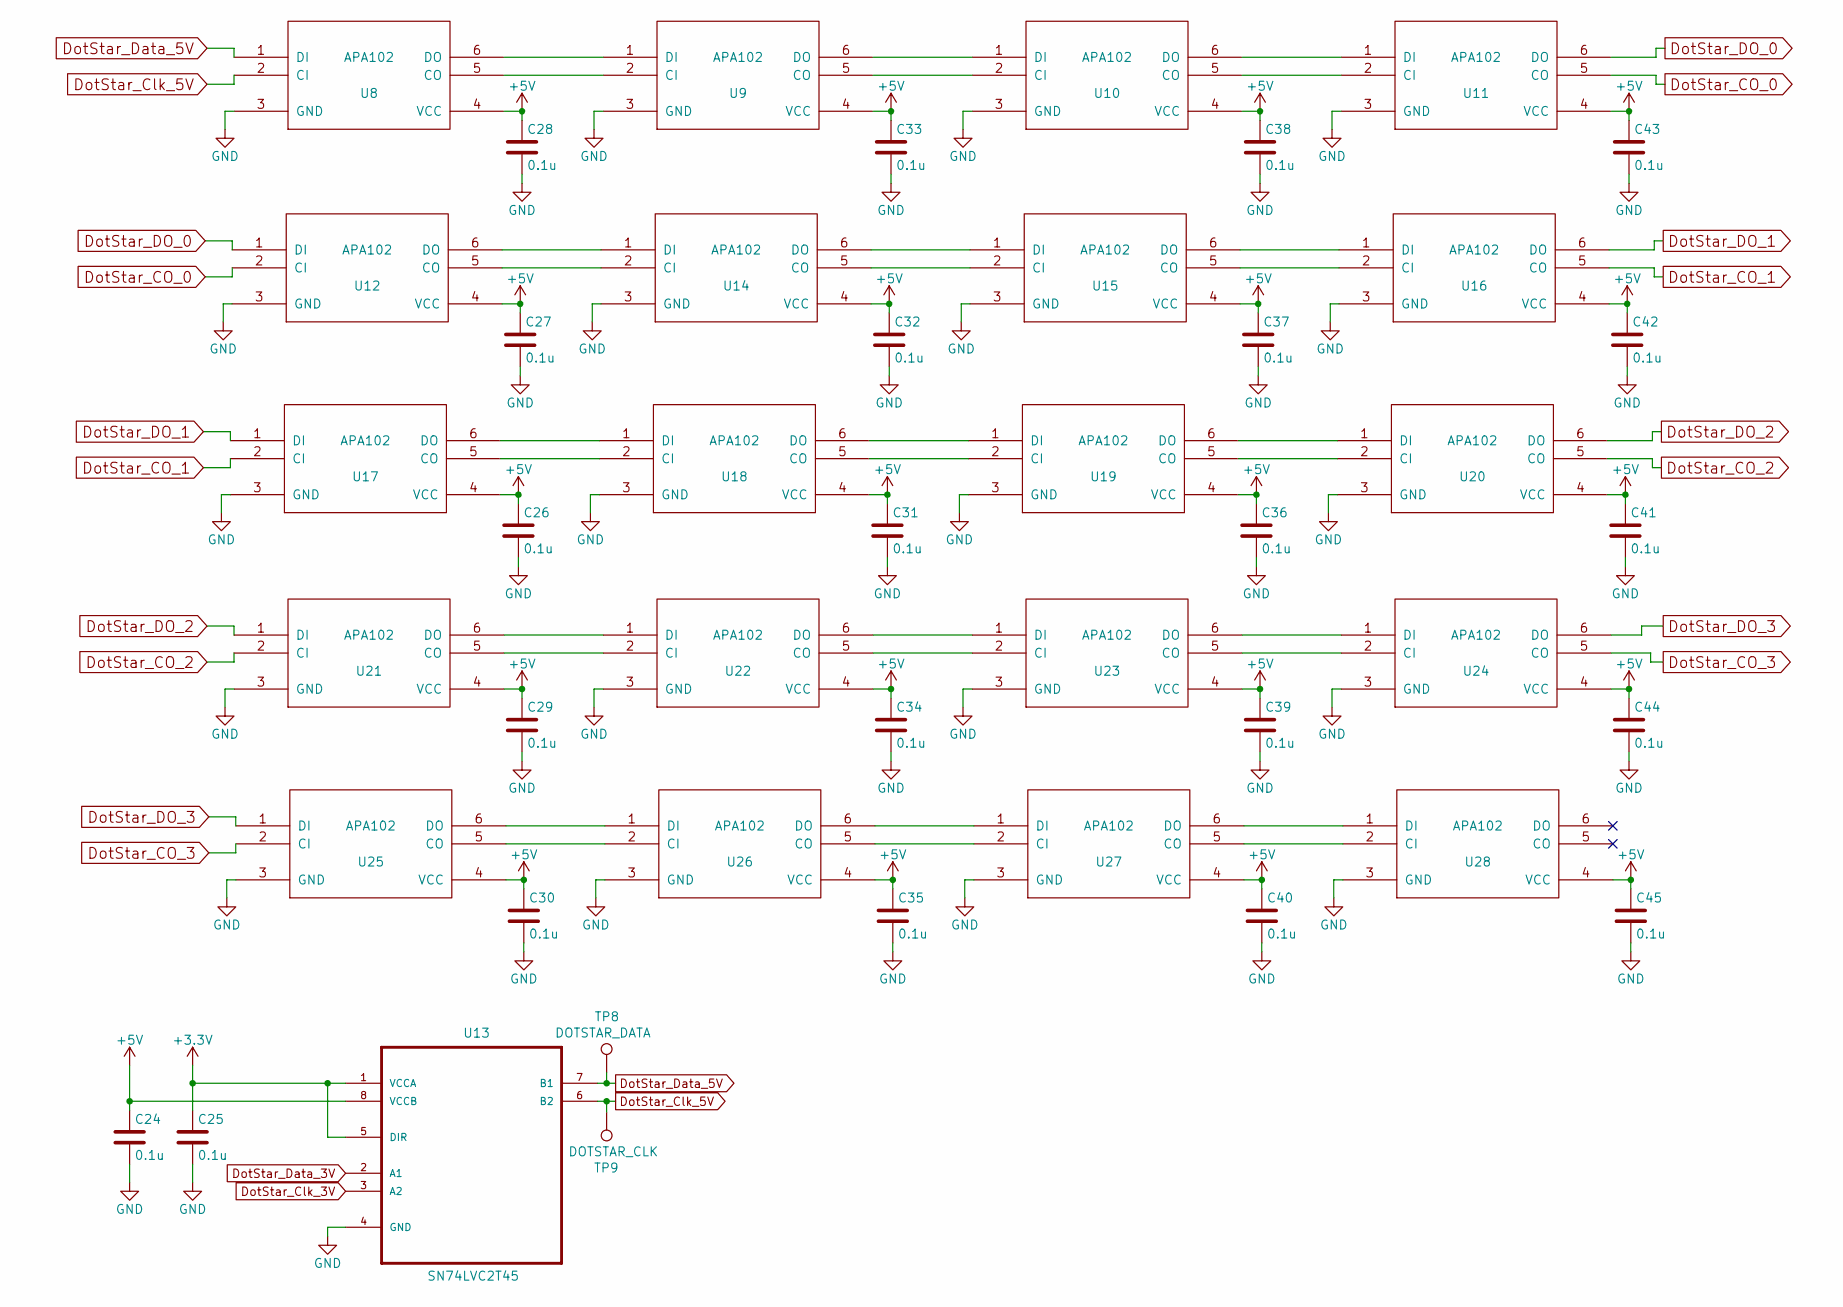
[picture p4: schematic DotStar.sch]

Parts:
C24, C25, C26, C27, C28, C29, C30, C31, C32, C33, C34, C35, C36, C37, C38, C39, C40, C41, C42, C43, C44, C45: 0.1u; C_0603_1608Metric_Pad1.05x0.95mm_HandSolder
TP8: DOTSTAR_DATA; TestPoint_Pad_2.0x2.0mm
TP9: DOTSTAR_CLK; TestPoint_Pad_2.0x2.0mm
U8, U9, U10, U11, U12, U14, U15, U16, U17, U18, U19, U20, U21, U22, U23, U24, U25, U26, U27, U28: APA102; APA102_hand_solder
U13: SN74LVC2T45; SOP50P310X90-8N

Connections:
+3V3: C25.1, U13.1 (VCCA), U13.5 (DIR); also elsewhere on the board
+5V: C24.1, C26.1, C27.1, C28.1, C29.1, C30.1, C31.1, C32.1, C33.1, C34.1, C35.1, C36.1, C37.1, C38.1, C39.1, C40.1, C41.1, C42.1, C43.1, C44.1, C45.1, U8.4 (VCC), U9.4 (VCC), U10.4 (VCC), U11.4 (VCC), U12.4 (VCC), U13.8 (VCCB), U14.4 (VCC), U15.4 (VCC), U16.4 (VCC), U17.4 (VCC), U18.4 (VCC), U19.4 (VCC), U20.4 (VCC), U21.4 (VCC), U22.4 (VCC), U23.4 (VCC), U24.4 (VCC), U25.4 (VCC), U26.4 (VCC), U27.4 (VCC), U28.4 (VCC); also elsewhere on the board
DotStar_CO_0: U11.5 (CO), U12.2 (CI)
DotStar_CO_1: U16.5 (CO), U17.2 (CI)
DotStar_CO_2: U20.5 (CO), U21.2 (CI)
DotStar_CO_3: U24.5 (CO), U25.2 (CI)
DotStar_Clk_3V: U13.3 (A2); also elsewhere on the board
DotStar_Clk_5V: TP9.1, U8.2 (CI), U13.6 (B2)
DotStar_DO_0: U11.6 (DO), U12.1 (DI)
DotStar_DO_1: U16.6 (DO), U17.1 (DI)
DotStar_DO_2: U20.6 (DO), U21.1 (DI)
DotStar_DO_3: U24.6 (DO), U25.1 (DI)
DotStar_Data_3V: U13.2 (A1); also elsewhere on the board
DotStar_Data_5V: TP8.1, U8.1 (DI), U13.7 (B1)
GND: C24.2, C25.2, C26.2, C27.2, C28.2, C29.2, C30.2, C31.2, C32.2, C33.2, C34.2, C35.2, C36.2, C37.2, C38.2, C39.2, C40.2, C41.2, C42.2, C43.2, C44.2, C45.2, U8.3 (GND), U9.3 (GND), U10.3 (GND), U11.3 (GND), U12.3 (GND), U13.4 (GND), U14.3 (GND), U15.3 (GND), U16.3 (GND), U17.3 (GND), U18.3 (GND), U19.3 (GND), U20.3 (GND), U21.3 (GND), U22.3 (GND), U23.3 (GND), U24.3 (GND), U25.3 (GND), U26.3 (GND), U27.3 (GND), U28.3 (GND); also elsewhere on the board
unnamed: U8.5 (CO), U9.2 (CI)
unnamed: U8.6 (DO), U9.1 (DI)
unnamed: U9.6 (DO), U10.1 (DI)
unnamed: U9.5 (CO), U10.2 (CI)
unnamed: U10.5 (CO), U11.2 (CI)
unnamed: U10.6 (DO), U11.1 (DI)
unnamed: U12.5 (CO), U14.2 (CI)
unnamed: U12.6 (DO), U14.1 (DI)
unnamed: U14.5 (CO), U15.2 (CI)
unnamed: U14.6 (DO), U15.1 (DI)
unnamed: U15.5 (CO), U16.2 (CI)
unnamed: U15.6 (DO), U16.1 (DI)
unnamed: U17.5 (CO), U18.2 (CI)
unnamed: U17.6 (DO), U18.1 (DI)
unnamed: U18.5 (CO), U19.2 (CI)
unnamed: U18.6 (DO), U19.1 (DI)
unnamed: U19.5 (CO), U20.2 (CI)
unnamed: U19.6 (DO), U20.1 (DI)
unnamed: U21.5 (CO), U22.2 (CI)
unnamed: U21.6 (DO), U22.1 (DI)
unnamed: U22.5 (CO), U23.2 (CI)
unnamed: U22.6 (DO), U23.1 (DI)
unnamed: U23.5 (CO), U24.2 (CI)
unnamed: U23.6 (DO), U24.1 (DI)
unnamed: U25.5 (CO), U26.2 (CI)
unnamed: U25.6 (DO), U26.1 (DI)
unnamed: U26.5 (CO), U27.2 (CI)
unnamed: U26.6 (DO), U27.1 (DI)
unnamed: U27.5 (CO), U28.2 (CI)
unnamed: U27.6 (DO), U28.1 (DI)

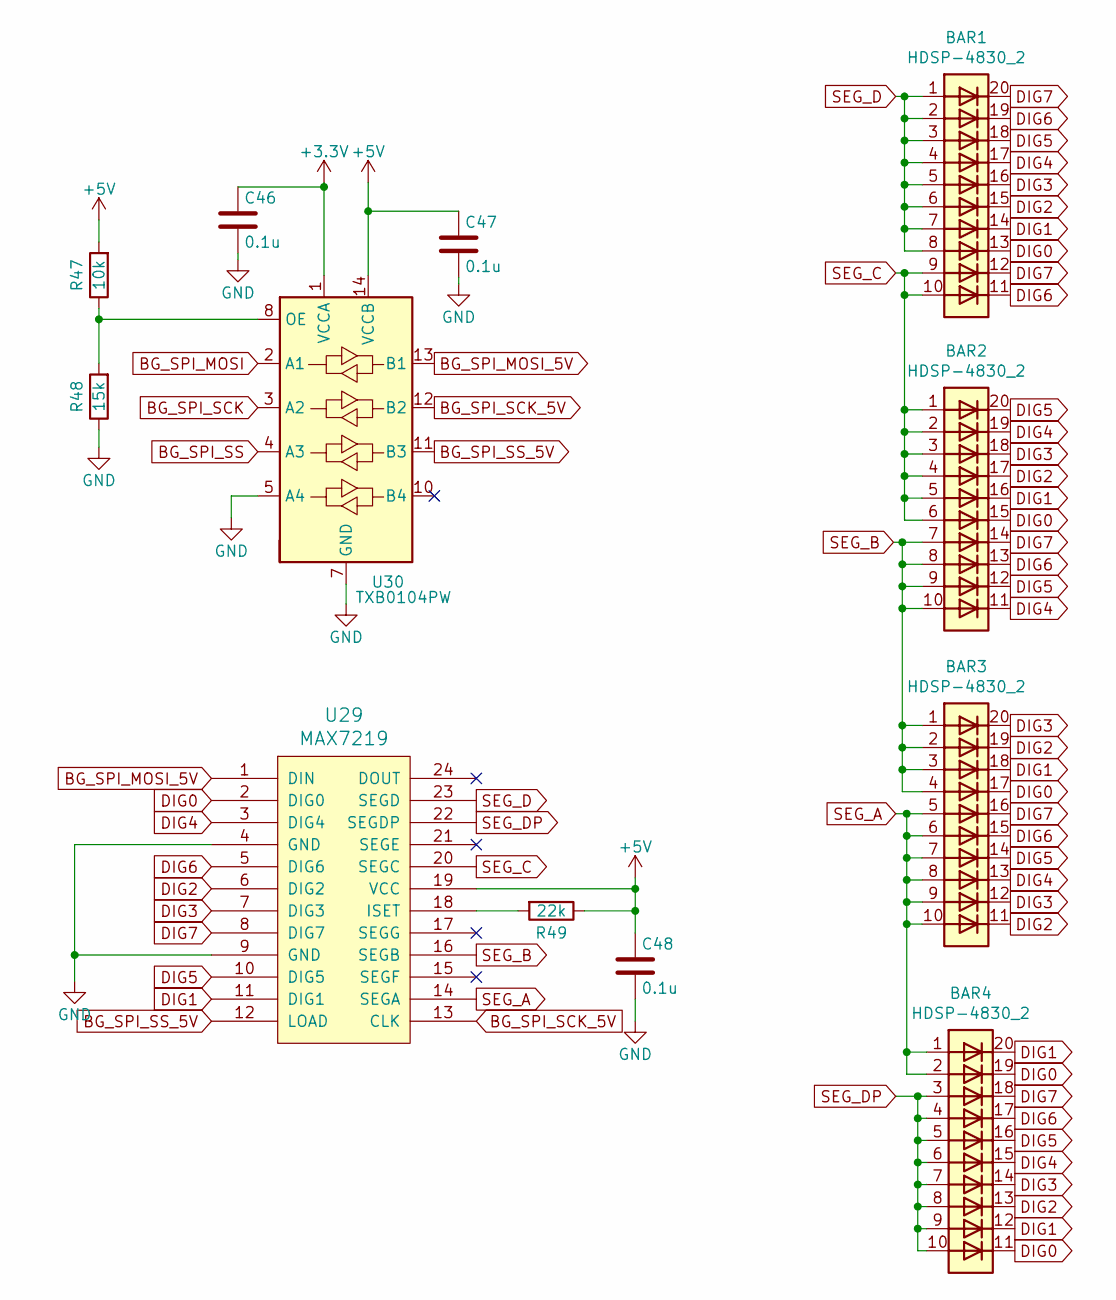
[picture p5: schematic BarGraph.sch]

Parts:
BAR1, BAR2, BAR3, BAR4: HDSP-4830_2; HDSP-4830
C46, C47, C48: 0.1u; C_0603_1608Metric_Pad1.05x0.95mm_HandSolder
R47: 10k; R_0603_1608Metric_Pad1.05x0.95mm_HandSolder
R48: 15k; R_0603_1608Metric_Pad1.05x0.95mm_HandSolder
R49: 22k; R_0603_1608Metric_Pad1.05x0.95mm_HandSolder
U29: MAX7219; SOIC-24W_7.5x15.4mm_P1.27mm
U30: TXB0104PW; TSSOP-14_4.4x5mm_P0.65mm

Connections:
+3V3: C46.1, U30.1 (VCCA); also elsewhere on the board
+5V: C47.1, C48.1, R47.2, R49.1, U29.19 (VCC), U30.14 (VCCB); also elsewhere on the board
BG_SPI_MOSI: U30.2 (A1); also elsewhere on the board
BG_SPI_MOSI_5V: U29.1 (DIN), U30.13 (B1)
BG_SPI_SCK: U30.3 (A2); also elsewhere on the board
BG_SPI_SCK_5V: U29.13 (CLK), U30.12 (B2)
BG_SPI_SS: U30.4 (A3); also elsewhere on the board
BG_SPI_SS_5V: U29.12 (LOAD), U30.11 (B3)
DIG0: BAR1.13 (K), BAR2.15 (K), BAR3.17 (K), BAR4.11 (K), BAR4.19 (K), U29.2 (DIG0)
DIG1: BAR1.14 (K), BAR2.16 (K), BAR3.18 (K), BAR4.12 (K), BAR4.20 (K), U29.11 (DIG1)
DIG2: BAR1.15 (K), BAR2.17 (K), BAR3.11 (K), BAR3.19 (K), BAR4.13 (K), U29.6 (DIG2)
DIG3: BAR1.16 (K), BAR2.18 (K), BAR3.12 (K), BAR3.20 (K), BAR4.14 (K), U29.7 (DIG3)
DIG4: BAR1.17 (K), BAR2.11 (K), BAR2.19 (K), BAR3.13 (K), BAR4.15 (K), U29.3 (DIG4)
DIG5: BAR1.18 (K), BAR2.12 (K), BAR2.20 (K), BAR3.14 (K), BAR4.16 (K), U29.10 (DIG5)
DIG6: BAR1.11 (K), BAR1.19 (K), BAR2.13 (K), BAR3.15 (K), BAR4.17 (K), U29.5 (DIG6)
DIG7: BAR1.12 (K), BAR1.20 (K), BAR2.14 (K), BAR3.16 (K), BAR4.18 (K), U29.8 (DIG7)
GND: C46.2, C47.2, C48.2, R48.1, U29.4 (GND), U29.9 (GND), U30.5 (A4), U30.7 (GND); also elsewhere on the board
unnamed: R47.1, R48.2, U30.8 (OE)
unnamed: R49.2, U29.18 (ISET)
SEG_A: BAR3.5 (A), BAR3.6 (A), BAR3.7 (A), BAR3.8 (A), BAR3.9 (A), BAR3.10 (A), BAR4.1 (A), BAR4.2 (A), U29.14 (SEGA)
SEG_B: BAR2.7 (A), BAR2.8 (A), BAR2.9 (A), BAR2.10 (A), BAR3.1 (A), BAR3.2 (A), BAR3.3 (A), BAR3.4 (A), U29.16 (SEGB)
SEG_C: BAR1.9 (A), BAR1.10 (A), BAR2.1 (A), BAR2.2 (A), BAR2.3 (A), BAR2.4 (A), BAR2.5 (A), BAR2.6 (A), U29.20 (SEGC)
SEG_D: BAR1.1 (A), BAR1.2 (A), BAR1.3 (A), BAR1.4 (A), BAR1.5 (A), BAR1.6 (A), BAR1.7 (A), BAR1.8 (A), U29.23 (SEGD)
SEG_DP: BAR4.3 (A), BAR4.4 (A), BAR4.5 (A), BAR4.6 (A), BAR4.7 (A), BAR4.8 (A), BAR4.9 (A), BAR4.10 (A), U29.22 (SEGDP)

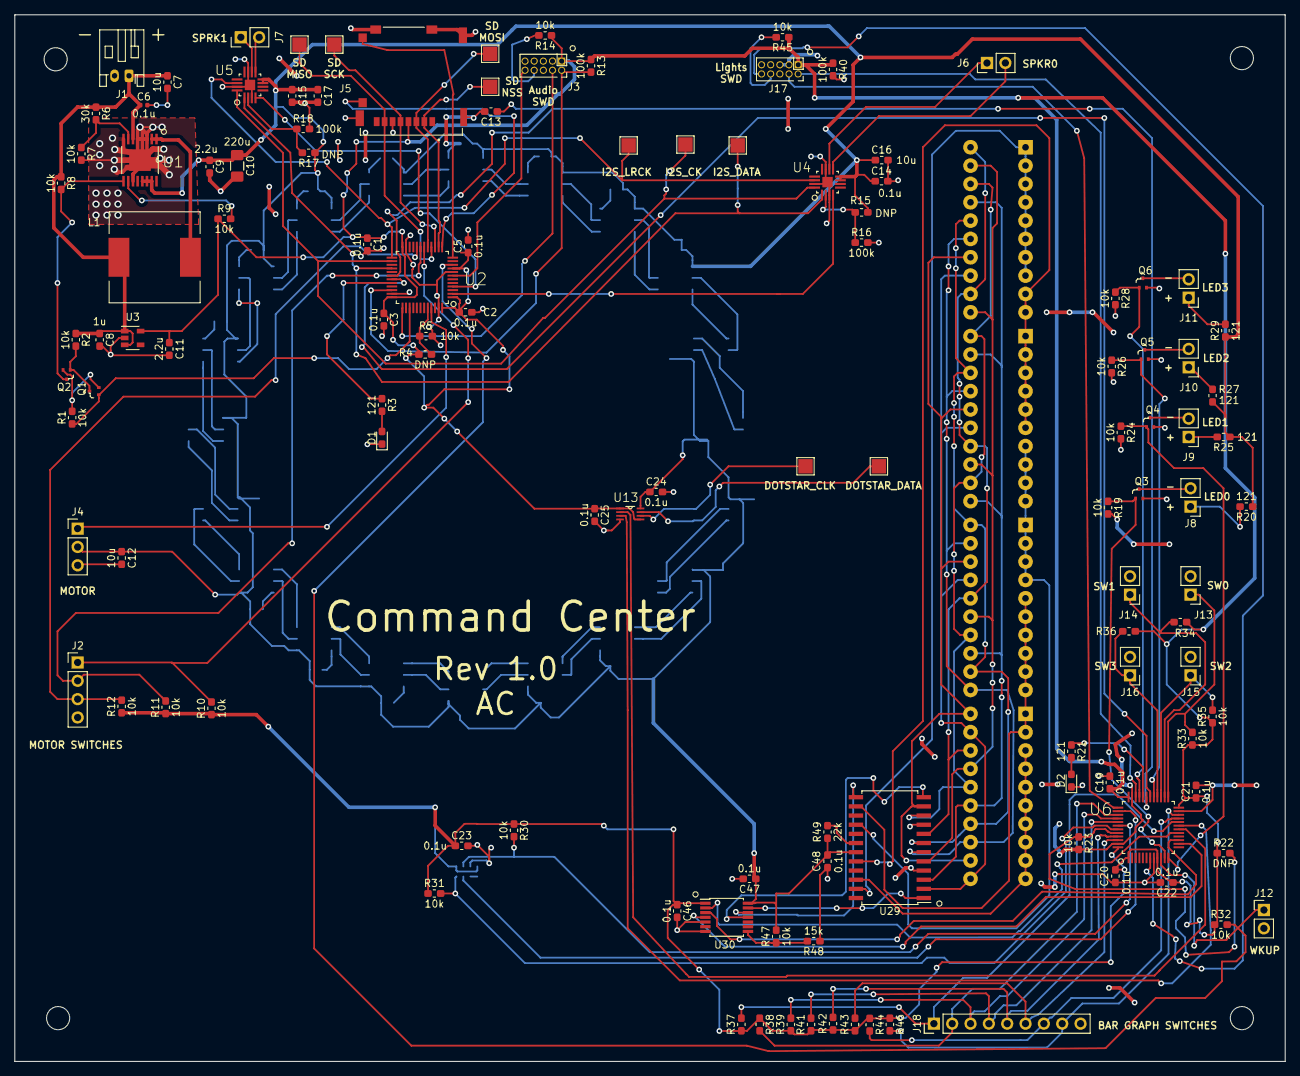
[picture p6: board CommandCenter_KICAD.kicad_pcb from above]

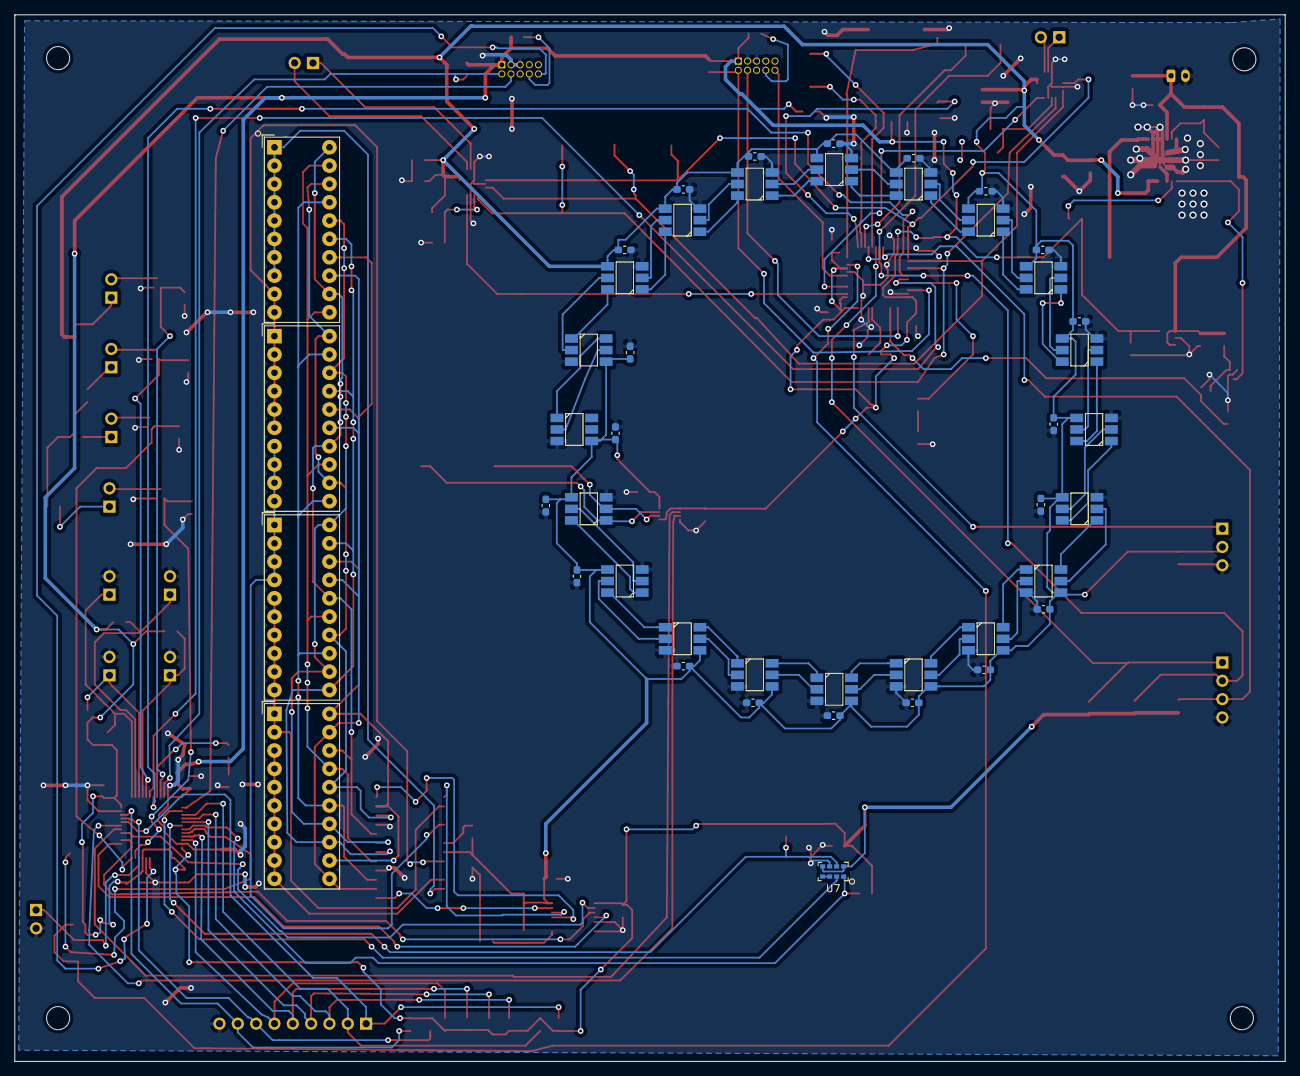
[picture p7: board CommandCenter_KICAD.kicad_pcb from below]

Board: 2 copper layers, 176.0 x 145.0 mm, 169 parts (45 on the bottom side), 139 nets.

Other parts of the board:
MKe: Mounting_Hole; MountingHole_3.2mm_M3
