carrola1/CommandCenter/Software/CommandCenter_Audio/Inc/main.h

#define AUDIO_SD_N_0_Pin GPIO_PIN_13
#define AUDIO_SD_N_0_GPIO_Port GPIOC
#define AUDIO_SD_N_1_Pin GPIO_PIN_15
#define AUDIO_SD_N_1_GPIO_Port GPIOC
#define SD_DETECT_Pin GPIO_PIN_2
#define SD_DETECT_GPIO_Port GPIOA
#define SD_CS_Pin GPIO_PIN_4
#define SD_CS_GPIO_Port GPIOA
#define SD_SW_Pin GPIO_PIN_3
#define SD_SW_GPIO_Port GPIOA
#define WKUP_Pin GPIO_PIN_0
#define WKUP_GPIO_Port GPIOA
#define MOTOR_SW_0_Pin GPIO_PIN_0
#define MOTOR_SW_0_GPIO_Port GPIOB
#define MOTOR_SW_1_Pin GPIO_PIN_1
#define MOTOR_SW_1_GPIO_Port GPIOB
#define MOTOR_CTRL_Pin GPIO_PIN_2
#define MOTOR_CTRL_GPIO_Port GPIOB
#define TEST_LED_Pin GPIO_PIN_11
#define TEST_LED_GPIO_Port GPIOA
#define PWR_ENB_Pin GPIO_PIN_3
#define PWR_ENB_GPIO_Port GPIOB
#define MOTOR_SW_2_Pin GPIO_PIN_8
#define MOTOR_SW_2_GPIO_Port GPIOB
#define AUDIO_TRIG_SW0          0
#define AUDIO_TRIG_SW1          1
#define AUDIO_TRIG_SW2          2
#define AUDIO_TRIG_SW3          3
#define AUDIO_TRIG_BG_UP        4
#define AUDIO_TRIG_BG_DOWN      5
#define AUDIO_TRIG_START        6
#define AUDIO_TRIG_FIND_RED     7
#define AUDIO_TRIG_FIND_GREEN   8
#define AUDIO_TRIG_FIND_BLUE    9
#define AUDIO_TRIG_FIND_YELLOW  10
#define AUDIO_TRIG_FIND_PURPLE  11
#define AUDIO_TRIG_FIND_PINK    12
#define AUDIO_TRIG_FIND_ORANGE  13
#define AUDIO_TRIG_FOUND_RED    14
#define AUDIO_TRIG_FOUND_GREEN  15
#define AUDIO_TRIG_FOUND_BLUE   16
#define AUDIO_TRIG_FOUND_YELLOW 17
#define AUDIO_TRIG_FOUND_PURPLE 18
#define AUDIO_TRIG_FOUND_PINK   19
#define AUDIO_TRIG_FOUND_ORANGE 20
#define AUDIO_TRIG_MISS_RED     21
#define AUDIO_TRIG_MISS_GREEN   22
#define AUDIO_TRIG_MISS_BLUE    23
#define AUDIO_TRIG_MISS_YELLOW  24
#define AUDIO_TRIG_MISS_PURPLE  25
#define AUDIO_TRIG_MISS_PINK    26
#define AUDIO_TRIG_MISS_ORANGE  27
#define AUDIO_TRIG_PETE         28
#define AUDIO_TRIG_SNUGGLE_PUP  29
#define AUDIO_TRIG_ELMO         30
