carrola1/CommandCenter/Software/CommandCenter_Light/Inc/LedControl.h

/*
 *    LedControl.h - A library for controling Leds with a MAX7219/MAX7221
 *    Copyright (c) 2007 Eberhard Fahle
 * 
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
 *    This permission notice shall be included in all copies or 
 *    substantial portions of the Software.
 * 
 *    THE SOFTWARE IS PROVIDED "AS IS", WITHOUT WARRANTY OF ANY KIND,
 *    EXPRESS OR IMPLIED, INCLUDING BUT NOT LIMITED TO THE WARRANTIES
 *    OF MERCHANTABILITY, FITNESS FOR A PARTICULAR PURPOSE AND
 *    NONINFRINGEMENT. IN NO EVENT SHALL THE AUTHORS OR COPYRIGHT
 *    HOLDERS BE LIABLE FOR ANY CLAIM, DAMAGES OR OTHER LIABILITY,
 *    WHETHER IN AN ACTION OF CONTRACT, TORT OR OTHERWISE, ARISING
 *    FROM, OUT OF OR IN CONNECTION WITH THE SOFTWARE OR THE USE OR
 *    OTHER DEALINGS IN THE SOFTWARE.
 */

#ifndef LedControl_h
#define LedControl_h

#include <stdint.h>

class LedControl {
    private :
        /* The array for shifting the data to the devices */
        uint8_t spidata[2];
        /* Send out a single command to the device */
        void spiTransfer(int addr, uint8_t opcode, uint8_t data);

        /* We keep track of the led-status for all 8 devices in this array */
        uint8_t status[64];

        int maxDevices;

    public:
        /* 
         * Create a new controler 
         * Params :
         * dataPin		pin on the Arduino where data gets shifted out
         * clockPin		pin for the clock
         * csPin		pin for selecting the device 
         * numDevices	maximum number of devices that can be controled
         */
        LedControl(int numDevices);

        /*
         * Gets the number of devices attached to this LedControl.
         * Returns :
         * int	the number of devices on this LedControl
         */
        int getDeviceCount();

        /* 
         * Set the shutdown (power saving) mode for the device
         * Params :
         * addr	The address of the display to control
         * status	If true the device goes into power-down mode. Set to false
         *		for normal operation.
         */
        void shutdown(int addr, bool status);

        /* 
         * Set the number of digits (or rows) to be displayed.
         * See datasheet for sideeffects of the scanlimit on the brightness
         * of the display.
         * Params :
         * addr	address of the display to control
         * limit	number of digits to be displayed (1..8)
         */
        void setScanLimit(int addr, int limit);

        /* 
         * Set the brightness of the display.
         * Params:
         * addr		the address of the display to control
         * intensity	the brightness of the display. (0..15)
         */
        void setIntensity(int addr, int intensity);

        /* 
         * Switch all Leds on the display off. 
         * Params:
         * addr	address of the display to control
         */
        void clearDisplay(int addr);

        /* 
         * Set the status of a single Led.
         * Params :
         * addr	address of the display 
         * row	the row of the Led (0..7)
         * col	the column of the Led (0..7)
         * state	If true the led is switched on, 
         *		if false it is switched off
         */
        void setLed(int addr, int row, int col, bool state);

        /* 
         * Set all 8 Led's in a row to a new state
         * Params:
         * addr	address of the display
         * row	row which is to be set (0..7)
         * value	each bit set to 1 will light up the
         *		corresponding Led.
         */
        void setRow(int addr, int row, uint8_t value);

        /* 
         * Set all 8 Led's in a column to a new state
         * Params:
         * addr	address of the display
         * col	column which is to be set (0..7)
         * value	each bit set to 1 will light up the
         *		corresponding Led.
         */
        void setColumn(int addr, int col, uint8_t value);

};

#endif	//LedControl.h
