carrola1/CommandCenter/Software/CommandCenter_Light/Src/LedControl.cpp

/*
 *    LedControl.cpp - A library for controling Leds with a MAX7219/MAX7221
 *    Copyright (c) 2007 Eberhard Fahle
 * 
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
 *    This permission notice shall be included in all copies or 
 *    substantial portions of the Software.
 * 
 *    THE SOFTWARE IS PROVIDED "AS IS", WITHOUT WARRANTY OF ANY KIND,
 *    EXPRESS OR IMPLIED, INCLUDING BUT NOT LIMITED TO THE WARRANTIES
 *    OF MERCHANTABILITY, FITNESS FOR A PARTICULAR PURPOSE AND
 *    NONINFRINGEMENT. IN NO EVENT SHALL THE AUTHORS OR COPYRIGHT
 *    HOLDERS BE LIABLE FOR ANY CLAIM, DAMAGES OR OTHER LIABILITY,
 *    WHETHER IN AN ACTION OF CONTRACT, TORT OR OTHERWISE, ARISING
 *    FROM, OUT OF OR IN CONNECTION WITH THE SOFTWARE OR THE USE OR
 *    OTHER DEALINGS IN THE SOFTWARE.
 */


#include "LedControl.h"
#include "spi.h"
#include "main.h"

//the opcodes for the MAX7221 and MAX7219
#define OP_NOOP   0
#define OP_DIGIT0 1
#define OP_DIGIT1 2
#define OP_DIGIT2 3
#define OP_DIGIT3 4
#define OP_DIGIT4 5
#define OP_DIGIT5 6
#define OP_DIGIT6 7
#define OP_DIGIT7 8
#define OP_DECODEMODE  9
#define OP_INTENSITY   10
#define OP_SCANLIMIT   11
#define OP_SHUTDOWN    12
#define OP_DISPLAYTEST 15

LedControl::LedControl(int numDevices) {
    if(numDevices<=0 || numDevices>8 )
        numDevices=8;
    maxDevices=numDevices;
    for(int i=0;i<64;i++) 
        status[i]=0x00;
    for(int i=0;i<maxDevices;i++) {
        spiTransfer(i,OP_DISPLAYTEST,0);
        //scanlimit is set to max on startup
        setScanLimit(i,7);
        //decode is done in source
        spiTransfer(i,OP_DECODEMODE,0);
        clearDisplay(i);
        //we go into shutdown-mode on startup
        shutdown(i,true);
    }
}

int LedControl::getDeviceCount() {
    return maxDevices;
}

void LedControl::shutdown(int addr, bool b) {
    if(addr<0 || addr>=maxDevices)
        return;
    if(b)
        spiTransfer(addr, OP_SHUTDOWN,0);
    else
        spiTransfer(addr, OP_SHUTDOWN,1);
}

void LedControl::setScanLimit(int addr, int limit) {
    if(addr<0 || addr>=maxDevices)
        return;
    if(limit>=0 && limit<8)
        spiTransfer(addr, OP_SCANLIMIT,limit);
}

void LedControl::setIntensity(int addr, int intensity) {
    if(addr<0 || addr>=maxDevices)
        return;
    if(intensity>=0 && intensity<16)	
        spiTransfer(addr, OP_INTENSITY,intensity);
}

void LedControl::clearDisplay(int addr) {
    int offset;

    if(addr<0 || addr>=maxDevices)
        return;
    offset=addr*8;
    for(int i=0;i<8;i++) {
        status[offset+i]=0;
        spiTransfer(addr, i+1,status[offset+i]);
    }
}

void LedControl::setLed(int addr, int row, int column, bool state) {
    int offset;
    uint8_t val=0x00;

    if(addr<0 || addr>=maxDevices)
        return;
    if(row<0 || row>7 || column<0 || column>7)
        return;
    offset=addr*8;
    val=0b10000000 >> column;
    if(state)
        status[offset+row]=status[offset+row]|val;
    else {
        val=~val;
        status[offset+row]=status[offset+row]&val;
    }
    spiTransfer(addr, row+1,status[offset+row]);
}

void LedControl::setRow(int addr, int row, uint8_t value) {
    int offset;
    if(addr<0 || addr>=maxDevices)
        return;
    if(row<0 || row>7)
        return;
    offset=addr*8;
    status[offset+row]=value;
    spiTransfer(addr, row+1,status[offset+row]);
}

void LedControl::setColumn(int addr, int col, uint8_t value) {
    uint8_t val;

    if(addr<0 || addr>=maxDevices)
        return;
    if(col<0 || col>7) 
        return;
    for(int row=0;row<8;row++) {
        val=value >> (7-row);
        val=val & 0x01;
        setLed(addr,row,col,val);
    }
}


void LedControl::spiTransfer(int addr, uint8_t opcode, uint8_t data) {

    //put our device data into the array
    spidata[1]=opcode;
    spidata[0]=data;

    //Now shift out the data 
    HAL_GPIO_WritePin(SPI_SS_GPIO_Port, SPI_SS_Pin, GPIO_PIN_RESET);
    HAL_SPI_Transmit(&hspi1, &spidata[0], 1, 1);
    while(HAL_SPI_GetState(&hspi1) != HAL_SPI_STATE_READY);
    HAL_GPIO_WritePin(SPI_SS_GPIO_Port, SPI_SS_Pin, GPIO_PIN_SET);
}    
