carrola1/CommandCenter/(commit log)

2019-04-29 Started PCB Schematic
    [Audio.sch, BarGraph.sch, CommandCenter_KICAD.sch, DotStar.sch, Light_Ctrl.sch]
2019-05-12 Layout started
    [Audio.sch, BarGraph.sch, CommandCenter_KICAD.kicad_pcb, CommandCenter_KICAD.sch, DotStar.sch, Light_Ctrl.sch, Part List.xlsx]
2019-08-28 Light Project Stable
    DotStars and bar graph working. Getting master read nack on I2C to color sensor.
    [CommandCenter_KICAD-B_Cu.gbr, CommandCenter_KICAD-B_Mask.gbr, CommandCenter_KICAD-B_Paste.gbr, CommandCenter_KICAD-B_SilkS.gbr, CommandCenter_KICAD-Edge_Cuts.gbr, CommandCenter_KICAD-F_Cu.gbr, CommandCenter_KICAD-F_Mask.gbr, CommandCenter_KICAD-F_Paste.gbr]
2019-09-02 Bar graph and color sensor working
    [CommandCenter_BOM.csv, CommandCenter_BOM.xlsx]
2019-09-11 Audio project working again
    Had to recreate STM32IDE project to get code to load. Not sure what fixed it. Audio amps were not initially working. Fixed by changing compile optimization from "None" to "Optimize for Size". This was the only difference I could find with the TrueStudio project (which did allow audio amps to work).
    [CommandCenter_Audio.ioc, main.c, main.h]
2019-10-16 Servo motor functioning.
2019-10-23 UART Working
2019-10-28 All hardware functional
    Sounds added for switch inputs.
2019-12-28 Adding color detection and new audio files.
    [Color_Sense_Cal.ods]
2019-12-28 Added color detect filtering and RNG for asking to find a random color.
2019-12-28 Added color found success/fail with audio triggers.
    [main.cpp]
2019-12-31 Wake/sleep key switch functionality added.
2020-01-03 Audio controller now provides UART feedback for when audio is playing
2020-01-03 Final release before mounting
2020-01-06 Added calibration routine on startup
2020-01-07 Fixed audio distortion
    Secret was to change GPIO speed of I2S signals.
    [wav_player.c]
2020-02-09 Reduced volume
    [Color_Sense_Cal.ods]
2020-03-23 Updated to play song even if color is wrong
    [dotstar.hpp, main.c, main.cpp]
2020-03-31 Re-architected software
    Re-wrote code to use state machines. Cleaned up variable names. Moved common code blocks to functions. Updated audio to play in chunks, allowing the process to be interrupted.
